arnaujane/RLP-ROBOBET/Presentació final Robobet.pptx

## ROBOBET

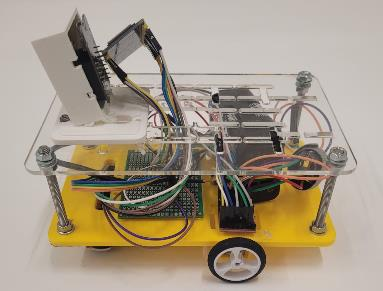
[picture p2: figure]

#Plataforma para apostar sobre la resolución de un laberinto donde el usuario tiene visión limitada.

Robòtica, llenguatge I planificació – Enginyeria informàtica - uab

#Amin El Alam

#Roger Casanovas

#Ferran Fernandez

#Arnau Jané

## 1. Arquitectura hardware i software

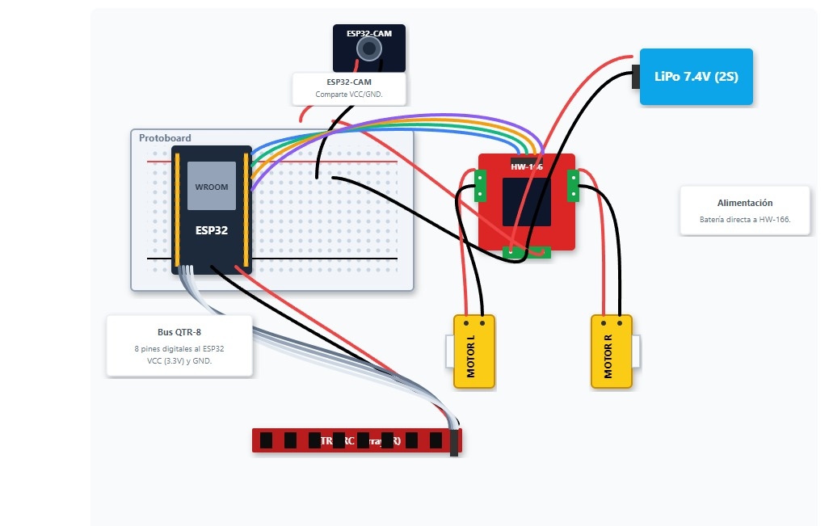
[picture p3: figure]
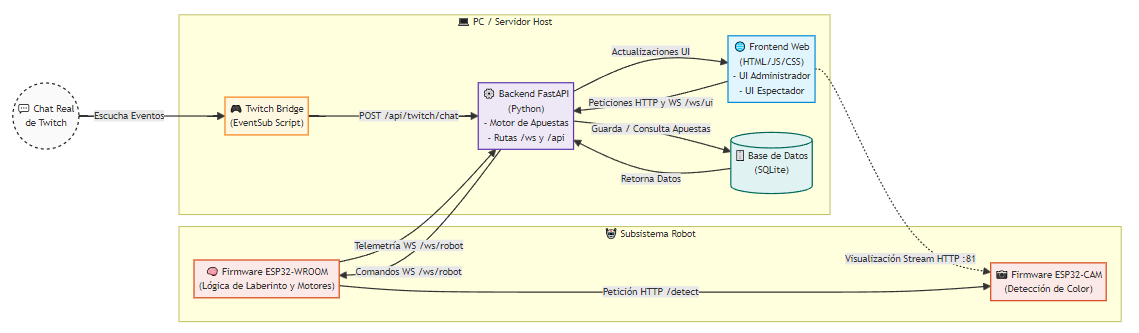
[picture p4: figure]

## 2. Algorísmica

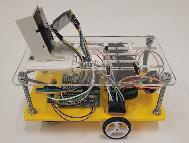
[picture p5: figure]
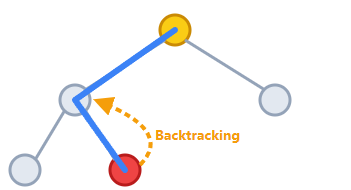
[picture p6: figure]
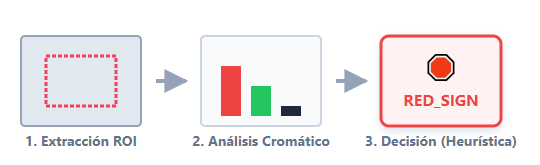
[picture p7: figure]

## FOTOS, VIDEO i Git

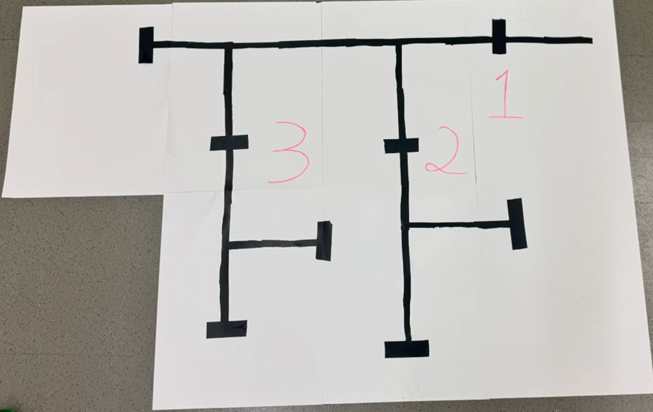
[picture p8: figure]

Robobet.mp4 (https://uab-my.sharepoint.com/:v:/g/personal/1751116_uab_cat/IQBV_lq3qJ5JQYQ4Sx5wEbxvATAd8hErdUmmfhs4O93hOP0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)

https://github.com/arnaujane/RLP-ROBOBET.git
