arnaujane/RLP-ROBOBET/ROBOTNAME_RLP_Budget.xlsx

Sheet: Bricogeek
Name | Price | Units | Total | URL
TOTAL |  |  | 0

Sheet: Electan
Name | Price | Units | Total | URL
TOTAL |  |  | 0

Sheet: Farnell
Name | Price | Units | Total | URL
TOTAL |  |  | 0

Sheet: Diotronic
Name | Price | Units | Total | URL
Raspberry Pi 4 Modelo B 4GB RAM — RSP-0051 | 66.90 € | 1 | 66.90 €
Memoria MicroSD Kingston 32GB (Clase 10) — CPM-0081 | 5.95 € | 1 | 5.95 €
Cámara Raspberry Pi v2 - 8 Megapixels — RSP-0033 | 20.95 € | 1 | 20.95 € | Cámara Raspberry Pi v2 - 8 Megapixels BricoGeek 2510728 | BricoGeek.com (https://tienda.bricogeek.com/sensores-imagen/822-camara-raspberry-pi-v2-8-megapixels.html)
Cable para cámara Raspberry Pi - 30cm — PRO-0164 | 2.50 € | 1 | 2.50 € | Cable para cámara Raspberry Pi - 30cm Adafruit 1648 | BricoGeek.com (https://tienda.bricogeek.com/accesorios-raspberry-pi/972-cable-para-camara-raspberry-pi-30cm.html)
Controlador de motores DRV8835 para Raspberry Pi B | 21.95 € | 1 | 21.95 € | Controlador de motores DRV8835 para Raspberry Pi B+ Pololu 2753 | BricoGeek.com (https://tienda.bricogeek.com/expansiones-raspberry-pi/706-controlador-de-motores-drv8835-para-raspberry-pi-b.html)
Rueda loca plástico ABS 3/4 | 5.50 € | 1 | 5.50 € | Rueda loca metálica 3/8 Pololu 954 | BricoGeek.com (https://tienda.bricogeek.com/robotica/995-rueda-loca-plastico-abs-34.html)
Array de sensores infrarrojos QTR-8RC (Digital) — SEN-0017 | 9.95 € | 1 | 9.95 € | Array de sensores infrarrojos QTR-8RC (Digital) Pololu 961 | BricoGeek.com (https://tienda.bricogeek.com/componentes/257-array-de-sensores-infrarojos-qtr-8rc-digital.html)
Motor Micro Metal LP con reductora 30:1 | €19.50 | 2.00 | €39.00 | Motor Micro Metal DC con reductora 30:1 - Pololu Pololu 993 | BricoGeek.com (https://tienda.bricogeek.com/motores/114-motor-micro-metal-dc-con-reductora-30-1.html)
Rueda de goma 32x7mm (2 und) | €3.95 | 1.00 | 3.95 | Rueda de goma 32x7mm Pololu 1088 | BricoGeek.com (https://tienda.bricogeek.com/robotica/110-rueda-de-goma-32x7mm.html)
Batería Lipo 2000mAh / 3.7V - | €6.90 | 1.00 | €6.90 | Bateria Lipo 2000mAh, 3.7V modelo 505060 Sparkfun PRT-13855 | BricoGeek.com (https://tienda.bricogeek.com/baterias-lipo/55-bateria-lipo-2000mah.html)
Cargador de batería LiPo USB y DC | €17.80 | 1.00 | €17.80 | Cargador de batería LiPo USB y DC Sparkfun PRT-12711 | BricoGeek.com (https://tienda.bricogeek.com/cargadores/48-cargador-de-bateria-lipo-usb-y-dc.html)
Conversor DC ajustable 4-25V | €16.95 | 1.00 | €16.95 | Conversor DC ajustable 4-25V Pololu 799 | BricoGeek.com (https://tienda.bricogeek.com/fuentes-de-alimentacion/184-conversor-dc-ajustable-4-25v.html)
 |  |  | €218.30
