arnaujane/RLP-ROBOBET/SCH_Schematic1_2026-05-20.pdf

# ESP32-WROOM Dev Board

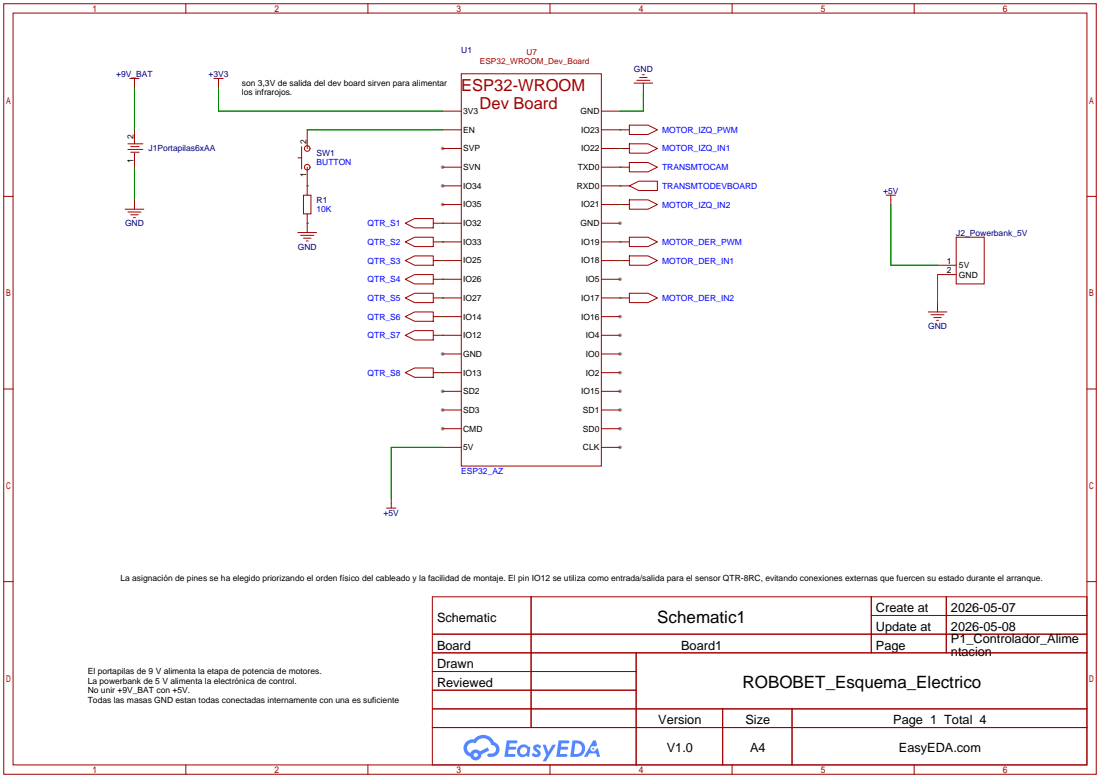
[picture p9: page 1]

son 3,3V de salida del dev board sirven para alimentar
los infrarojos.

La asignación de pines se ha elegido priorizando el orden físico del cableado y la facilidad de montaje. El pin IO12 se utiliza como entrada/salida para el sensor QTR-8RC, evitando conexiones externas que fuercen su estado durante el arranque.

Schematic | Schematic1 | Create at | 2026-05-07
Board | Board1 | Page | P1_Controlador_Alime
Drawn | | ROBOBET_Esquema_Electrico
Reviewed

Update at | 2026-05-08

El portapilas de 9 V alimenta la etapa de potencia de motores.
La powerbank de 5 V alimenta la electrónica de control.
No unir +9V_BAT con +5V.
Todas las masas GND estan todas conectadas internamente con una es suficiente

Version | Size | Page 1 Total 4
V1.0 | A4 | EasyEDA.com

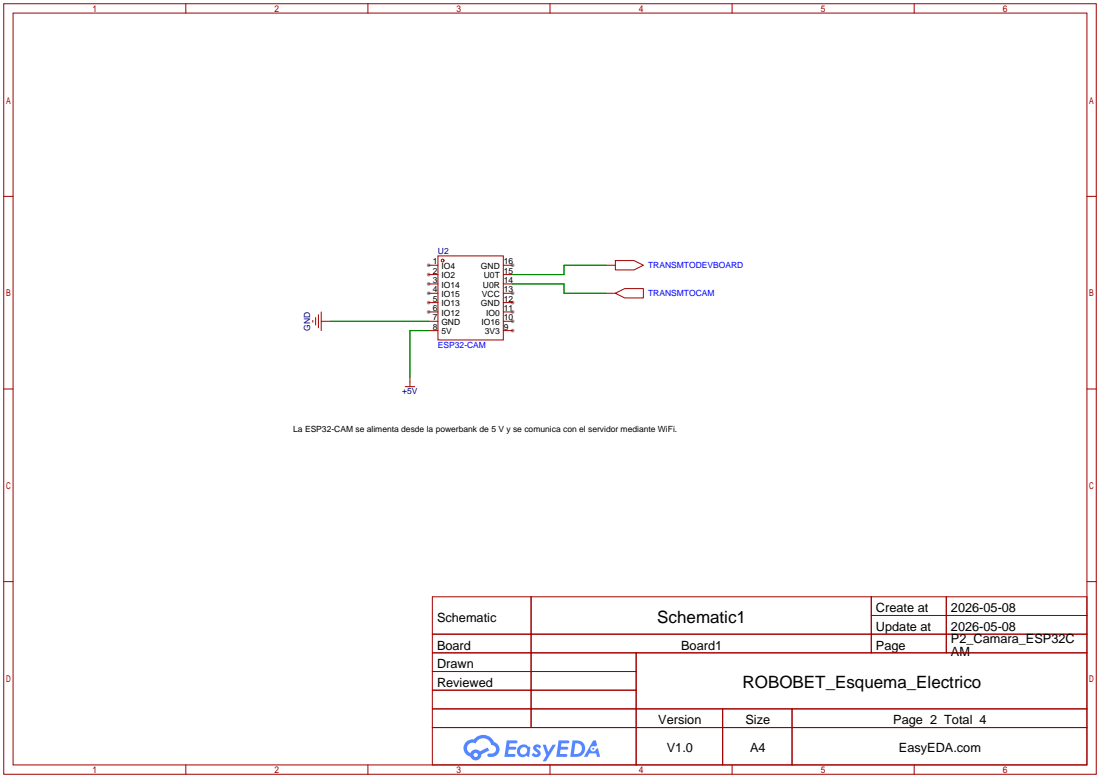
[picture p10: page 2]

La ESP32-CAM se alimenta desde la powerbank de 5 V y se comunica con el servidor mediante WiFi.

Schematic | Schematic1 | Create at | 2026-05-08
Board | Board1 | Page | P2_Camara_ESP32C
Drawn | | ROBOBET_Esquema_Electrico
Reviewed

Update at | 2026-05-08

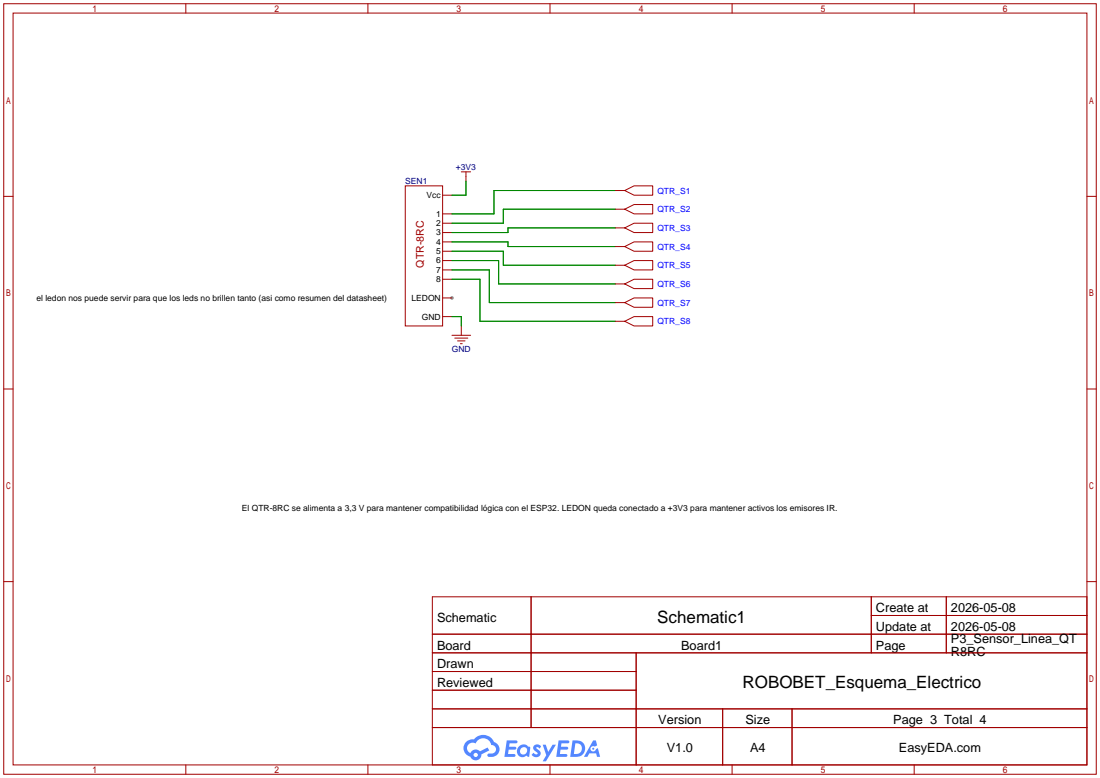
[picture p11: page 3]

el ledon nos puede servir para que los leds no brillen tanto (asi como resumen del datasheet)

El QTR-8RC se alimenta a 3,3 V para mantener compatibilidad lógica con el ESP32. LEDON queda conectado a +3V3 para mantener activos los emisores IR.

Schematic | Schematic1 | Create at | 2026-05-08
Board | Board1 | Page | P3_Sensor_Linea_QT
Drawn | | ROBOBET_Esquema_Electrico
Reviewed

Update at | 2026-05-08

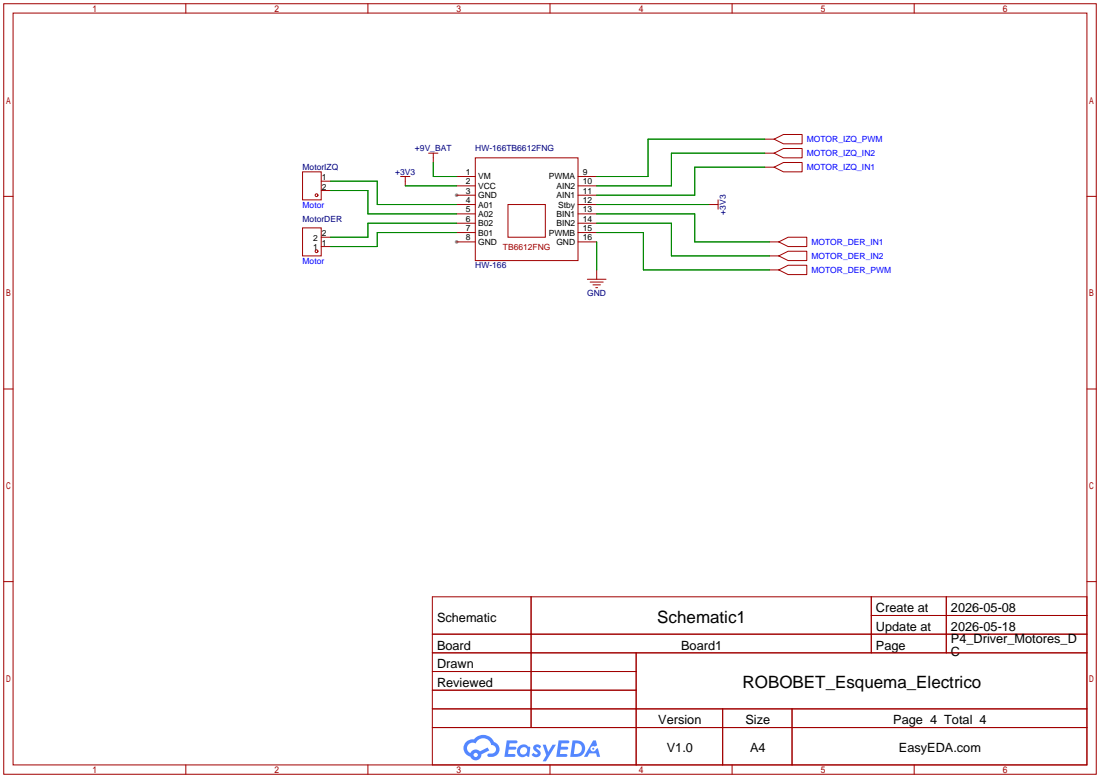
[picture p12: page 4]

Schematic | Schematic1 | Create at | 2026-05-08
Board | Board1 | Page | P4_Driver_Motores_D
Drawn | | ROBOBET_Esquema_Electrico
Reviewed

Update at | 2026-05-18
