arnaujane/RLP-ROBOBET/(commit log)

2026-05-06 Commit Inicial
    [componentes_medidas.csv]
2026-05-21 test solo va motor derecho adelante
2026-06-07 seguidor de lineas implementado
2026-06-11 Improve ESP32-CAM stream stability
    [main.cpp]
